peterrayn/solar/README.md

This project is for educational purposes.

Some code may originate/take inspiration from online tutorials or open-source repositories with unclear licensing status.
Efforts have been made to use permissive sources (e.g., MIT/Apache), but full attribution may be incomplete.

If any code is found to violate licensing terms, it will be removed upon request.
