peterrayn/solar/solar_system_hardware/solar_system/Core/Src/main.c

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
/* Includes ------------------------------------------------------------------*/
#include "main.h"
#include "i2c.h"
#include "iwdg.h"
#include "spi.h"
#include "tim.h"
#include "usart.h"
#include "gpio.h"

/* USER CODE BEGIN Includes */
# include "ST7735.h"
# include "GFX_FUNCTIONS.h"
# include "stdio.h"
# include "ina226.h"
# include "OneWire.h"
#include "bh1750.h"
#include "ESP8266_STM32.h"
#include "stdlib.h"

/* USER CODE END Includes */


/* USER CODE BEGIN PV */
uint8_t opeCode;              
uint8_t g_ucaDataBuff[2];     
float ftmp;                   
extern uint32_t read_DATA[5];
/* USER CODE END PV */

void SystemClock_Config(void);
/* USER CODE BEGIN 0 */
extern float Temp[MAXDEVICES_ON_THE_BUS];


extern uint32_t read_DATA[5];
char str_V[30],str_I[30],str_P[30],str_temper[40],str_Lux[30],str_data[50],str_spray[20],str_time[40];
float current,voltage,power;
uint16_t status0=0;



void sleep(){
	uint32_t timer=0;
//	printf("sleep\r\n");

    fillScreen(BLACK);
    ST7735_WriteString(10, 2, "SLEEPING...",Font_7x10, WHITE, BLACK);

	while(timer<3600){
	HAL_IWDG_Refresh(&hiwdg);
	HAL_Delay(1000);
	timer++;
	}
	status0 = 0;
    BKP->DR2 = status0;

}
/* USER CODE END 0 */

/**
  * @brief  The application entry point.
  * @retval int
  */
int main(void)
{
  /* MCU Configuration--------------------------------------------------------*/

  /* Reset of all peripherals, Initializes the Flash interface and the Systick. */
  HAL_Init();

  /* Configure the system clock */
  SystemClock_Config();

  /* Initialize all configured peripherals */
  MX_GPIO_Init();
  MX_I2C1_Init();
  MX_SPI1_Init();
  MX_USART2_UART_Init();
  MX_I2C2_Init();
  MX_USART1_UART_Init();
  MX_TIM2_Init();
  MX_IWDG_Init();
  /* USER CODE BEGIN 2 */

  

  INA226_init();
  ST7735_Init(0);

  fillScreen(BLACK);

  get_ROMid();

  BH1750_Init();
  opeCode= BH1750_CONT_HI_RSLT_1;
  BH1750_WriteOpecode(&opeCode,1);

  HAL_IWDG_Refresh(&hiwdg);


  
    __HAL_RCC_PWR_CLK_ENABLE();
    __HAL_RCC_BKP_CLK_ENABLE();

    
    HAL_PWR_EnableBkUpAccess();
//


    
      if (__HAL_RCC_GET_FLAG(RCC_FLAG_IWDGRST) != RESET)
      {
     
          status0 = BKP->DR2;

  
          __HAL_RCC_CLEAR_RESET_FLAGS();
      }
      else
      {

      
    		status0 = 0;
    	    BKP->DR2 = status0;
          __HAL_RCC_CLEAR_RESET_FLAGS();
      }




      HAL_GPIO_WritePin(GPIOB, GPIO_PIN_15, 0);
    fillScreen(BLACK);
    ST7735_WriteString(0, 2, "START RUNNING",Font_7x10, WHITE, BLACK);
    HAL_Delay(1000);


    HAL_Delay(1000);
    HAL_IWDG_Refresh(&hiwdg);

    char buf[30]="";
   	status0++;
   	BKP->DR2 = status0;
   	sprintf(buf,"restart num-> %u",status0);
   	ST7735_WriteString(2, 30, buf,Font_7x10, WHITE, BLACK);
   if (status0>3)sleep();






   HAL_IWDG_Refresh(&hiwdg);


   ESP_Init();
   fillScreen(BLACK);
  ST7735_WriteString(0, 2, "wifi connected",Font_7x10, WHITE, BLACK);
HAL_Delay(500);





HAL_IWDG_Refresh(&hiwdg);
fillScreen(BLACK);
ST7735_WriteString(2, 20, "ready to building connection",Font_11x18, WHITE, BLACK);
HAL_Delay(500);
if (stupid_SCAU("SCAUNET")!=ESP8266_OK){
	while(1);

}



  while (1)
  {
	  get_Temperature();


      BH1750_ReadData(g_ucaDataBuff,2);
      ftmp = (g_ucaDataBuff[0]<<8 | g_ucaDataBuff[1]) / 1.2f + 0.5f;


      voltage=INA226_GetBusV();
      current=INA226_GetCurrent();
      power=INA226_GetPower();


//      ESP_interact_once("1.1.1.1",Temp[0],Temp[1],Temp[2],Temp[4],Temp[3],ftmp,current, power, voltage);
      if(Interaction("1.2.3.4",1234,Temp[0],Temp[1],Temp[2],Temp[4],Temp[3],ftmp,current, power, voltage)==ESP8266_OK)
      {HAL_IWDG_Refresh(&hiwdg);
		status0 = 0;
	    BKP->DR2 = status0;

	  	  if (read_DATA[2]==1){
	  		  HAL_GPIO_WritePin(GPIOB, GPIO_PIN_15, 1);
	  	  }
	  	  else HAL_GPIO_WritePin(GPIOB, GPIO_PIN_15, 0);

      }
      else HAL_GPIO_WritePin(GPIOB, GPIO_PIN_15, 0);


/

	  	sprintf(str_V,"voltage: %.2f",voltage);
	  	sprintf(str_I,"current: %.2f",current);
	  	sprintf(str_P,"power: %.2f",power);
	  	sprintf(str_Lux,"illum %.2f",ftmp);
	  	sprintf(str_temper,"%.2f,%.2f,%.2f,%.2f,%.2f",Temp[0],Temp[1],Temp[2],Temp[3],Temp[4]);
	  	sprintf(str_spray,"is_spray -> %lu",read_DATA[2]);
	  	sprintf(str_time,"%lu--%lu",read_DATA[0],read_DATA[1]);

	  	  fillScreen(BLACK);
	  	  ST7735_WriteString(2, 2, str_V,Font_7x10, BLUE, BLACK);
	  	  ST7735_WriteString(2, 17, str_I,Font_7x10, BLUE, BLACK);
	  	  ST7735_WriteString(2, 32,str_P,Font_7x10, BLUE, BLACK);
	  	ST7735_WriteString(2, 47,str_Lux,Font_7x10, WHITE, BLACK);
	  	ST7735_WriteString(2, 62,"temperature",Font_7x10, WHITE, BLACK);
	  	ST7735_WriteString(2, 77,str_temper,Font_7x10, WHITE, BLACK);
	  	ST7735_WriteString(2, 107,"VPS connected",Font_7x10, GREEN, BLACK);



//	  	ST7735_WriteString(2, 125,str_time,Font_7x10, WHITE, BLACK);
//	  	ST7735_WriteString(2, 145,str_spray,Font_7x10, WHITE, BLACK);

	  	  HAL_GPIO_TogglePin(GPIOC, GPIO_PIN_13);



	  	  HAL_Delay(200);
    /* USER CODE END WHILE */

    /* USER CODE BEGIN 3 */
  }
  /* USER CODE END 3 */
}

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
