peterrayn/solar/solar_system_hardware/solar_system/solar_system.ioc

Mcu.UserName=STM32F103C8Tx
PA10.Signal=USART1_RX
PA2.Signal=USART2_TX
PA5.Signal=SPI1_SCK
PA6.GPIO_Label=CS
PA6.Signal=GPIO_Output
PA7.Signal=SPI1_MOSI
PA9.Signal=USART1_TX
PB0.GPIO_Label=RST
PB0.Signal=GPIO_Output
PB1.GPIO_Label=DC
PB1.Signal=GPIO_Output
PB10.Signal=I2C2_SCL
PB11.Signal=I2C2_SDA
PB15.GPIO_Label=Motorcontrol
PB15.Signal=GPIO_Output
PB6.Signal=I2C1_SCL
PB7.Signal=I2C1_SDA
PC13-TAMPER-RTC.Signal=GPIO_Output
PD0-OSC_IN.Signal=RCC_OSC_IN
PD1-OSC_OUT.Signal=RCC_OSC_OUT
