peterrayn/solar/solar_system_hardware/solar_system/Core/Inc/main.h

#define CS_Pin GPIO_PIN_6
#define CS_GPIO_Port GPIOA
#define RST_Pin GPIO_PIN_0
#define RST_GPIO_Port GPIOB
#define DC_Pin GPIO_PIN_1
#define DC_GPIO_Port GPIOB
#define Motorcontrol_Pin GPIO_PIN_15
#define Motorcontrol_GPIO_Port GPIOB
