peterrayn/solar/(notices)

Notices in the files:
solar_system_hardware/solar_system/Core/Src/main.c:
Copyright (c) 2026 STMicroelectronics.
All rights reserved.
This software is licensed under terms that can be found in the LICENSE file
